mwlaserswe/Frequenzumrichter/Doku Atmel programmieren/20200407_100606 (800 x 600).jpg

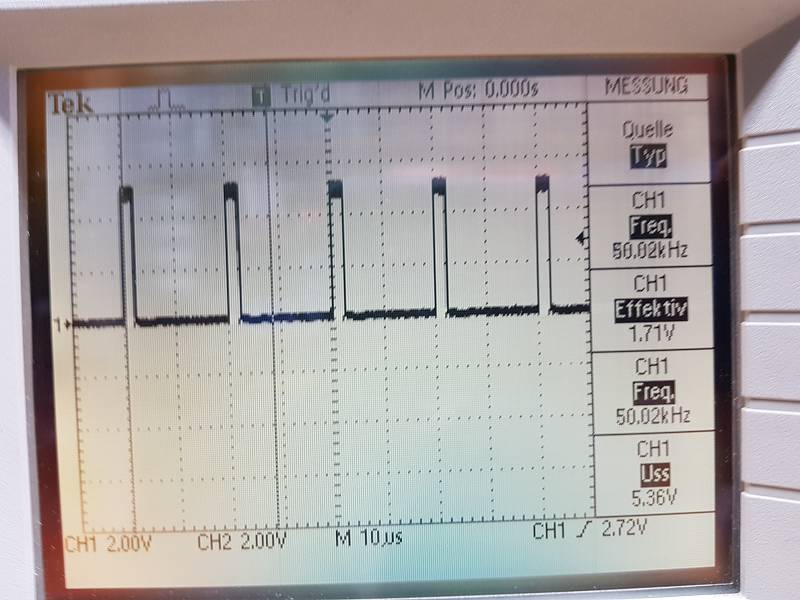
Doku Atmel programmieren/20200407_100606 (800 x 600).jpg
