mwlaserswe/Frequenzumrichter/Arduino/Arduion Uno Layout 2.jpg

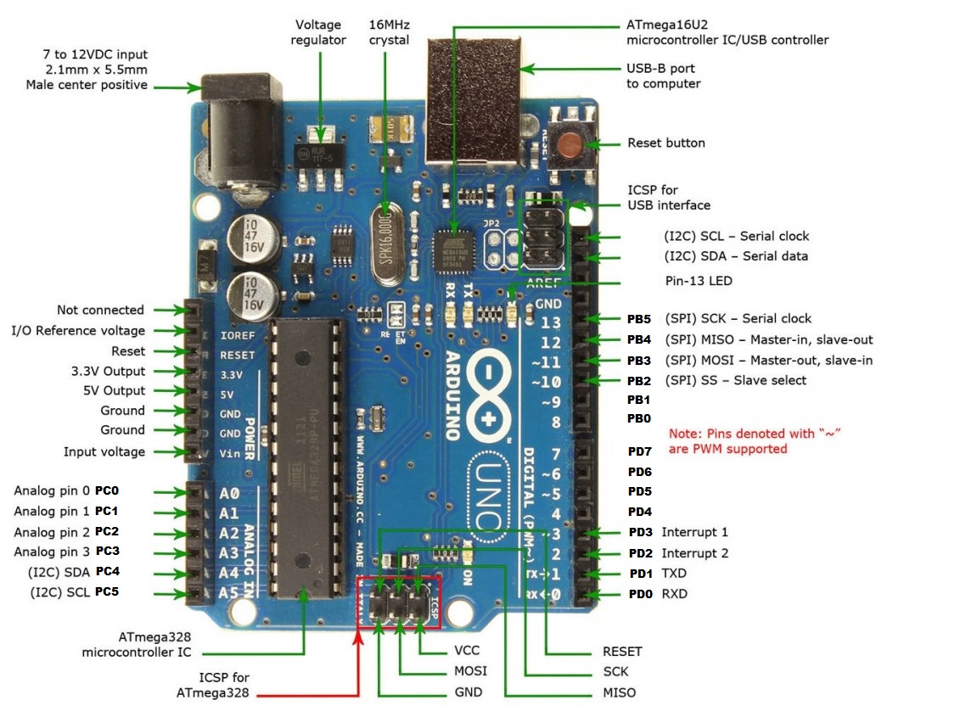
Arduino/Arduion Uno Layout 2.jpg
