mwlaserswe/Frequenzumrichter/Arduino/Arduion Uno Layout.jpg

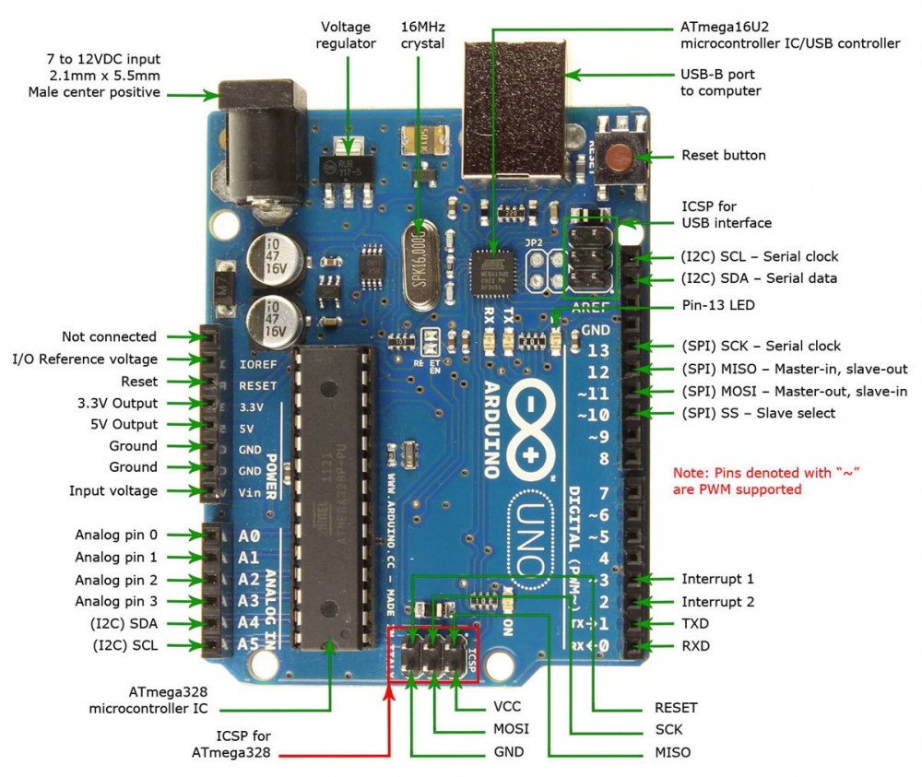
Arduino/Arduion Uno Layout.jpg
