mwlaserswe/Frequenzumrichter/Doku Atmel programmieren/20200329_140703 (800 x 600).jpg

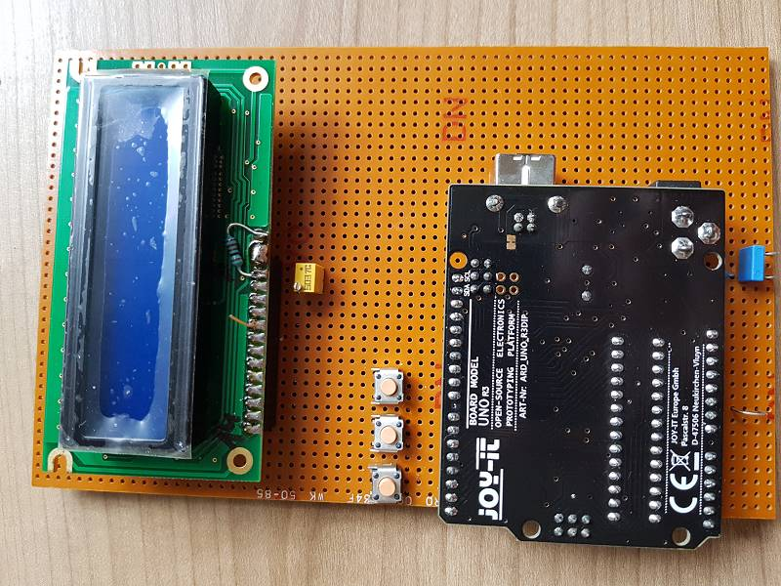
Doku Atmel programmieren/20200329_140703 (800 x 600).jpg
