mwlaserswe/Frequenzumrichter/Doku Atmel programmieren/20200329_143617 (800 x 600).jpg

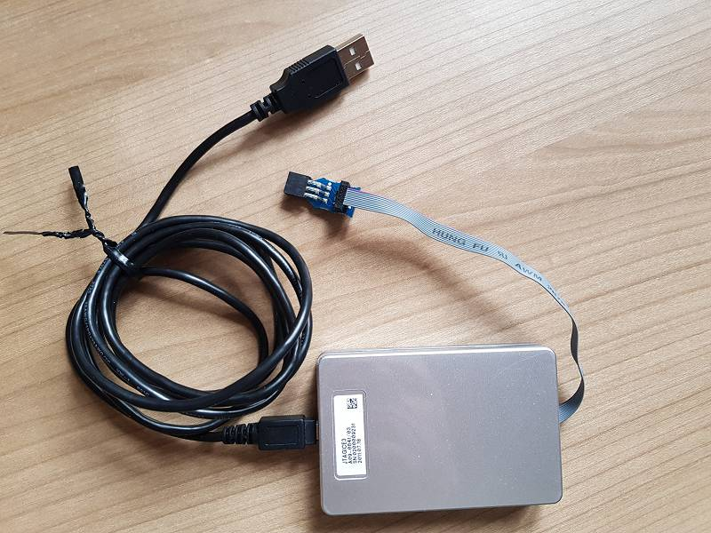
Doku Atmel programmieren/20200329_143617 (800 x 600).jpg
