mwlaserswe/Frequenzumrichter/Doku Atmel programmieren/20200329_144504 (800 x 600).jpg

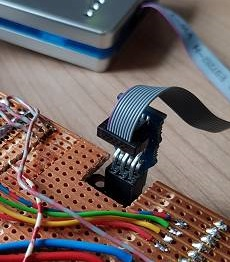
Doku Atmel programmieren/20200329_144504 (800 x 600).jpg
