mwlaserswe/Frequenzumrichter/Doku Atmel programmieren/20200402_160709 (800 x 600).jpg

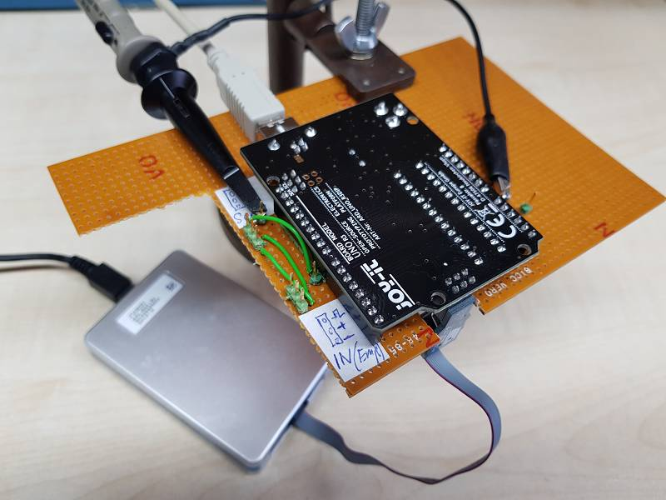
Doku Atmel programmieren/20200402_160709 (800 x 600).jpg
