mwlaserswe/Frequenzumrichter/Doku Atmel programmieren/20200406_111214.jpg

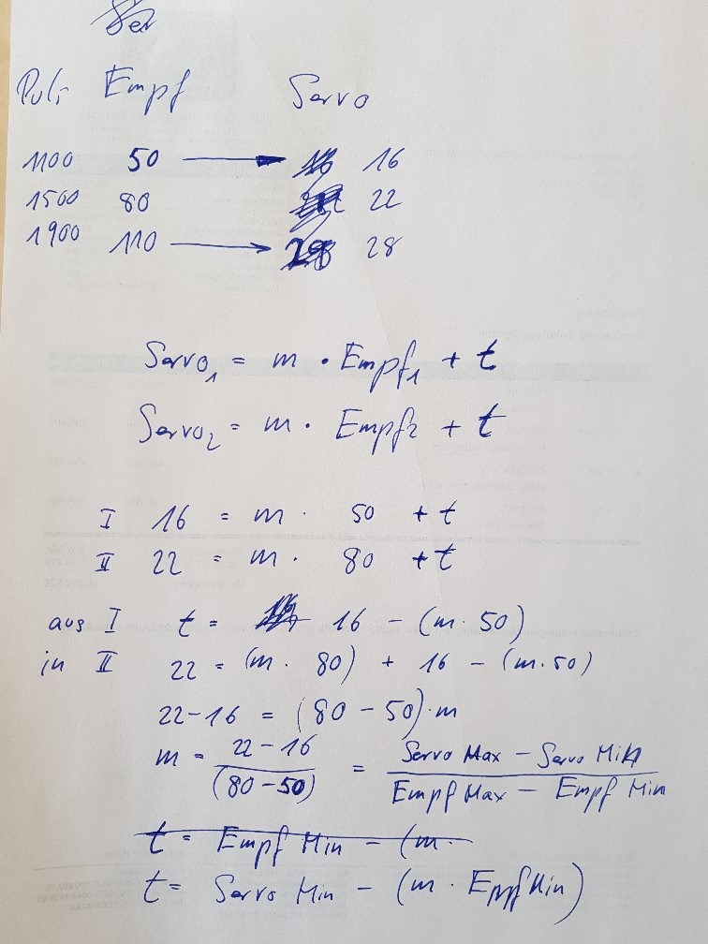
Doku Atmel programmieren/20200406_111214.jpg
