mwlaserswe/Frequenzumrichter/Doku Atmel programmieren/20200406_111307.jpg

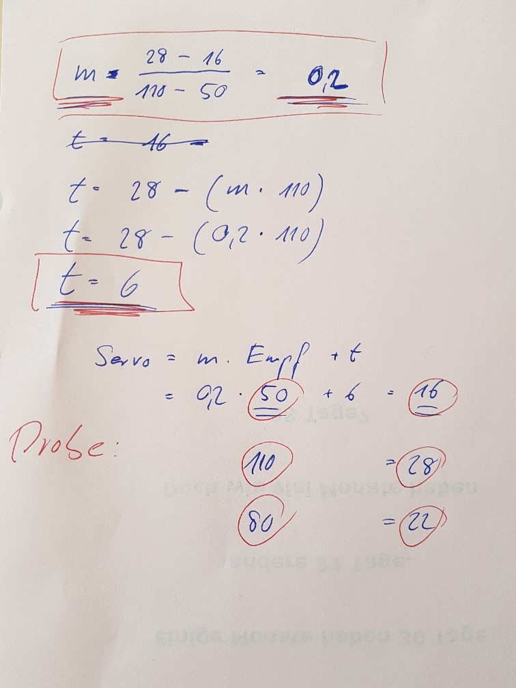
Doku Atmel programmieren/20200406_111307.jpg
