mwlaserswe/Frequenzumrichter/Doku Atmel programmieren/20200407_104357 (800 x 600).jpg

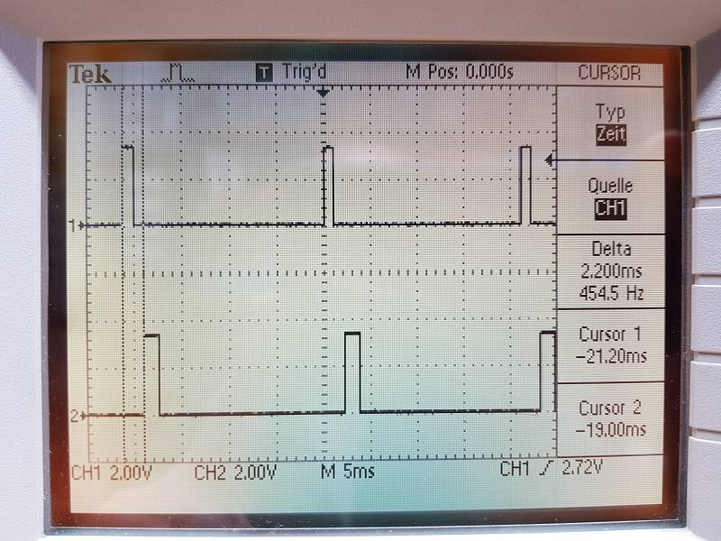
Doku Atmel programmieren/20200407_104357 (800 x 600).jpg
