mwlaserswe/Frequenzumrichter/VF_Sine_Drive/VFD_sinus_AT168/VF_Sine_Drive.png

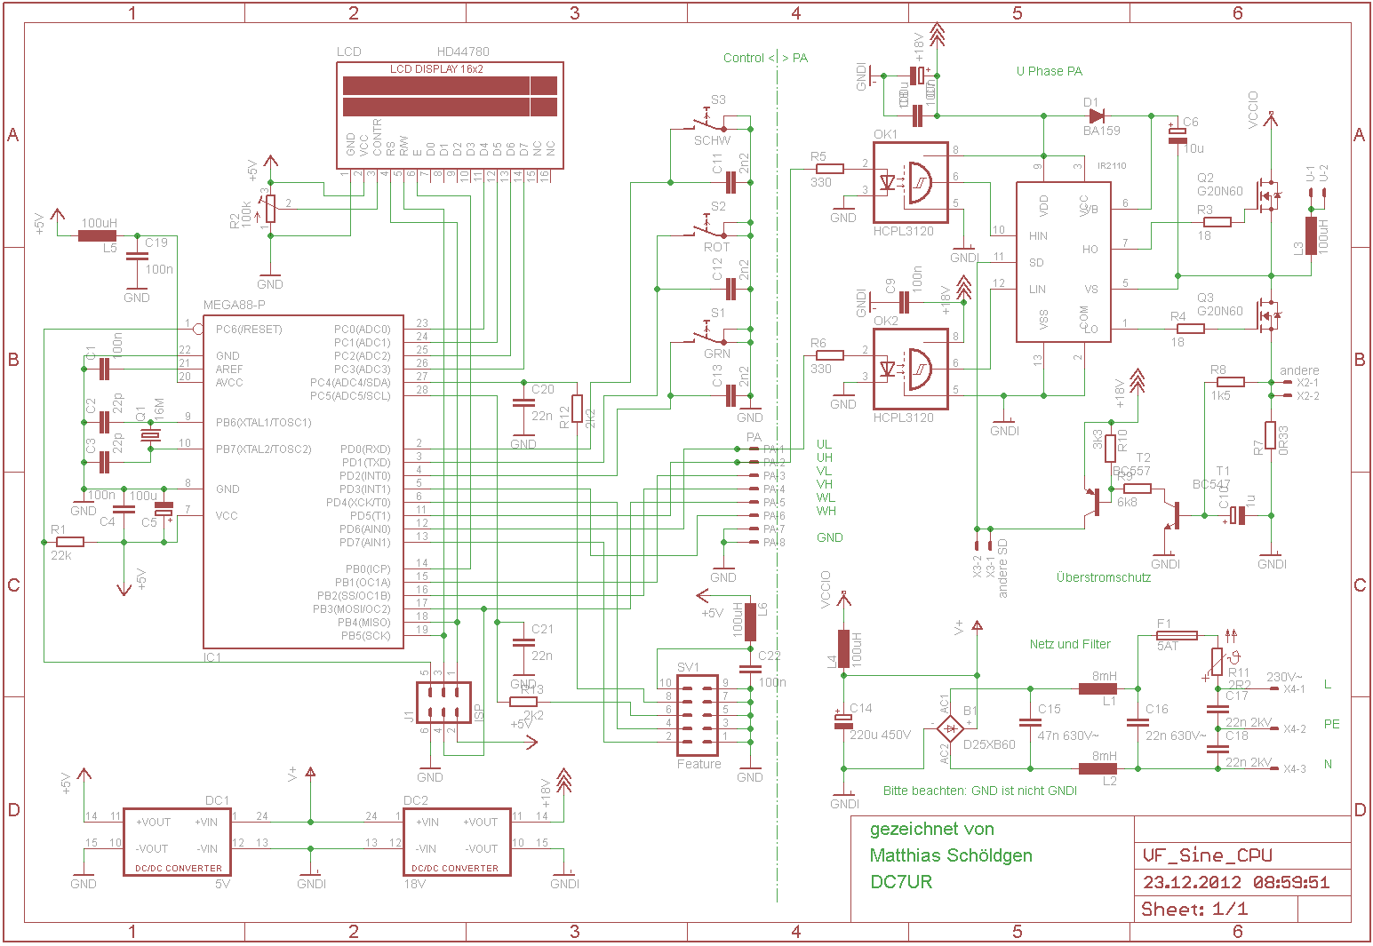
VF_Sine_Drive/VFD_sinus_AT168/VF_Sine_Drive.png
