mwlaserswe/Frequenzumrichter/VF_Sine_Drive/Eagle/VF_Sine_CPU_Mainboard2.brd

## EAGLE design VF_Sine_Drive/Eagle/VF_Sine_CPU_Mainboard2.brd (2018-12-28)

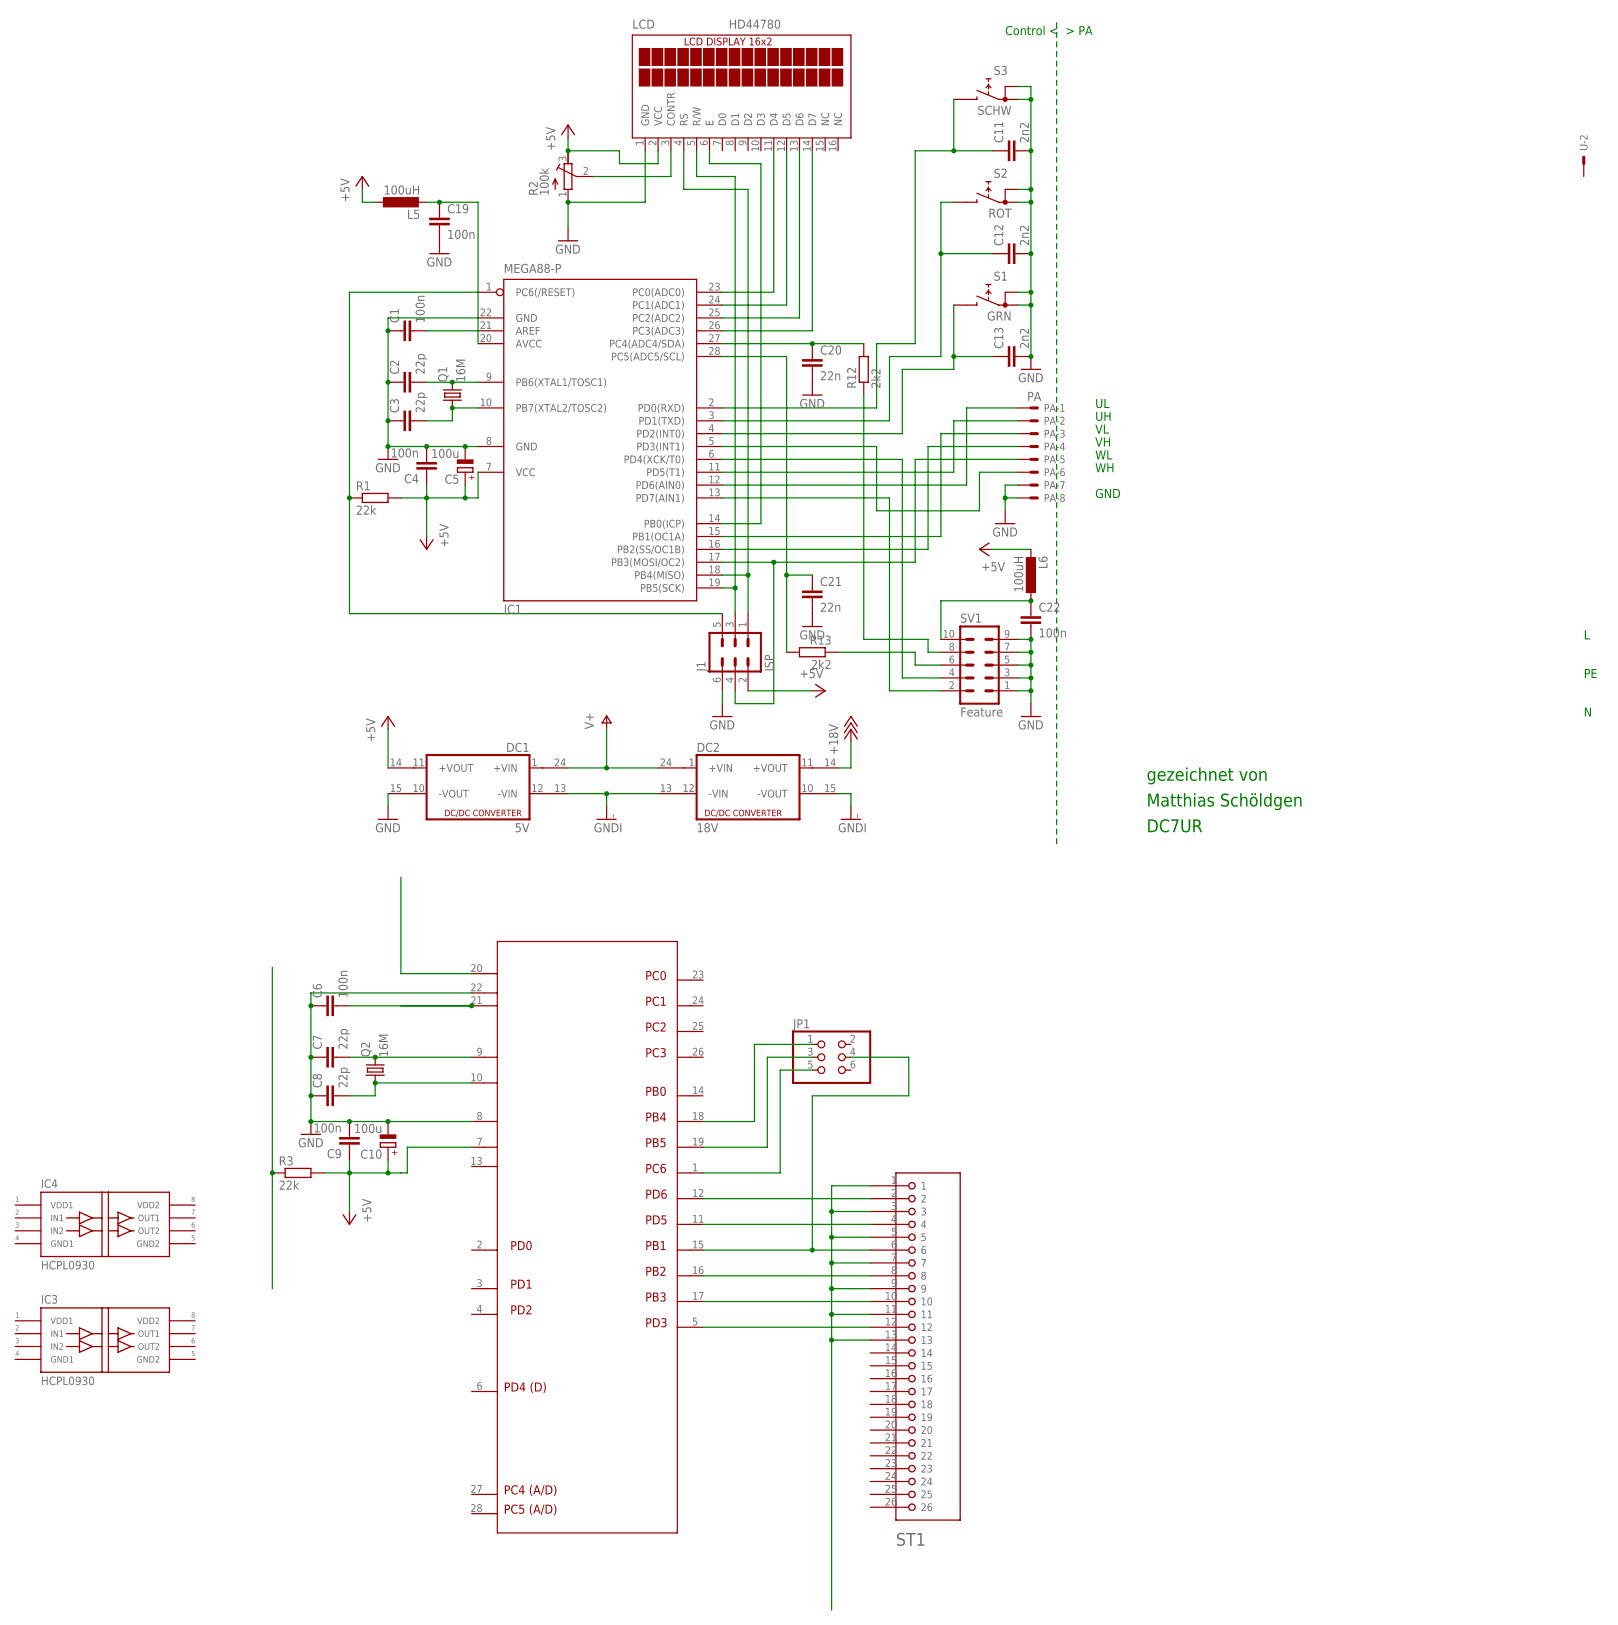
[picture p19: schematic VF_Sine_CPU_Mainboard2.sch]

Parts:
C1, C4, C6, C9, C22: 100n; C025-025X050
C2, C3, C7, C8: 22p; C025-025X050
C5, C10: 100u; B45181A
C11, C12, C13: 2n2; C025-025X050
C19: 100n; C050-030X075
C20, C21: 22n; C025-024X044
DC1: 5V; CMK
DC2: 18V; CMK
IC1: MEGA88-P; DIL28-3
IC2: ATMEGA328P_VAR; DIL-28S
IC3, IC4: HCPL0930; SO8
J1: ISP; ML6
JP1: PINHD-2X3; 2X03
L5, L6: 100uH; 0204/5
LCD: HD44780; TUXGR_16X2_R2
PA: PA; 22-23-2081
Q1, Q2: 16M; HC49/S
R1, R3: 22k; 0207/2V
R2: 100k; RTRIM4G/J
R12, R13: 2k2; 0204/5
S1: GRN; RDT1034
S2: ROT; RDT1034
S3: SCHW; RDT1034
ST1: HD-26
SV1: Feature; ML10
U: 5566-2

Connections:
+5V: C4.1, C5.+, C9.1, C10.+, DC1.14 (+VOUT1), IC1.7 (VCC), IC2.7, J1.2, L5.1, L6.2, LCD.2 (VCC), R1.2, R2.3 (A), R3.2
+18V: DC2.14 (+VOUT1)
GND: C1.1, C2.1, C3.1, C4.2, C5.-, C6.1, C7.1, C8.1, C9.2, C10.-, C11.2, C12.2, C13.2, C19.2, C20.2, C21.2, C22.2, DC1.15 (-VOUT1), IC1.8 (GND), IC1.22 (GND), IC2.8, IC2.22, J1.6, LCD.1 (GND), PA.7, PA.8, R2.1 (E), S1.A, S1.A1, S2.A, S2.A1, S3.A, S3.A1, SV1.1, SV1.3, SV1.5, SV1.7, SV1.9
GNDI: DC1.13 (-VIN1), DC2.13 (-VIN1), DC2.15 (-VOUT1)
unnamed: IC1.18 (PB4(MISO)), J1.1, LCD.4 (RS)
unnamed: IC1.19 (PB5(SCK)), J1.3, LCD.5 (R/W)
unnamed: IC1.17 (PB3(MOSI/OC2)), J1.4, PA.5
unnamed: IC1.1 (PC6(/RESET)), J1.5, R1.1
unnamed: IC1.12 (PD6(AIN0)), PA.1
unnamed: IC1.11 (PD5(T1)), PA.2
unnamed: IC1.15 (PB1(OC1A)), PA.3
unnamed: IC1.16 (PB2(SS/OC1B)), PA.4
unnamed: IC1.5 (PD3(INT1)), PA.6
unnamed: IC1.23 (PC0(ADC0)), LCD.11 (D4)
unnamed: IC1.24 (PC1(ADC1)), LCD.12 (D5)
unnamed: IC1.25 (PC2(ADC2)), LCD.13 (D6)
unnamed: C1.2, IC1.21 (AREF)
unnamed: C2.2, IC1.9 (PB6(XTAL1/TOSC1)), Q1.2
unnamed: C3.2, IC1.10 (PB7(XTAL2/TOSC2)), Q1.1
unnamed: IC1.26 (PC3(ADC3)), LCD.14 (D7)
unnamed: IC1.13 (PD7(AIN1)), SV1.2
unnamed: IC1.14 (PB0(ICP)), LCD.6 (E)
unnamed: LCD.3 (CONTR), R2.2 (S)
unnamed: IC1.6 (PD4(XCK/T0)), SV1.4
unnamed: R12.1, SV1.8
unnamed: R13.1, SV1.6
unnamed: C13.1, IC1.4 (PD2(INT0)), S1.B
unnamed: C12.1, IC1.3 (PD1(TXD)), S2.B
unnamed: C11.1, IC1.2 (PD0(RXD)), S3.B
unnamed: ST1.1, ST1.3, ST1.5, ST1.7, ST1.9, ST1.11, ST1.13
unnamed: IC2.12, ST1.2
unnamed: IC2.11, ST1.4
unnamed: IC2.15, JP1.4, ST1.6
unnamed: IC2.16, ST1.8
unnamed: IC2.17, ST1.10
unnamed: IC2.5, ST1.12
unnamed: IC2.18, JP1.1
unnamed: IC2.19, JP1.3
unnamed: IC2.1, JP1.5
unnamed: C19.1, IC1.20 (AVCC), L5.2
unnamed: C20.1, IC1.27 (PC4(ADC4/SDA)), R12.2
unnamed: C21.1, IC1.28 (PC5(ADC5/SCL)), R13.2
unnamed: C6.2, IC2.21
unnamed: C7.2, IC2.9, Q2.2
unnamed: C8.2, IC2.10, Q2.1
unnamed: C22.1, L6.1, SV1.10
V+: DC1.24 (+VIN1), DC2.24 (+VIN1)

Notes on the sheet:
GND
Matthias Schöldgen
gezeichnet von
DC7UR
Control < > PA
PD5
PD6
PB1
PB2
PB3
PD3
PC1
PC0
PC2
PC3
PB4
PB0
PB5
PC6
PD0
PD1
PD2
PD4 (D)
PC4 (A/D)
PC5 (A/D)

Board: 2 copper layers, 42 parts (0 on the bottom side), 46 nets, no tracks yet.
