mwlaserswe/Frequenzumrichter/VF_Sine_Drive/VFD_sinus_AT168_TST2/GccApplication1/vfdtables.h

 /*  Variable Frequency Drive with AVR ATMega 88/168/328    */
/*! \file *********************************************************************
 *
 *
 *      This file contains the table definitions used for sine control.
 *
 * \par Based on Application note:
 *      AVR447: Sinusoidal driving of three-phase permanent motor using
 *      ATmega48/88/168
 *
 * \par Documentation
 *      For comprehensive code documentation, supported compilers, compiler
 *      settings and supported devices see readme.html
 *
 * \author
 *      Atmel Corporation: http://www.atmel.com \n
 *      Support email: avr@atmel.com
 * 	by Matthias Schoeldgen - DC7UR 
 * $Name: RELEASE_1_0 $
 * $Revision: 1.4 $
 * $RCSfile: PMSMtables.h,v $
 * $Date: 2010/04/16 11:57:20 $  \n
 ******************************************************************************/

#define PURE_SINE_DRIVE 1

#ifndef _PMSM_TABLES_H_
#define _PMSM_TABLES_H_

#ifdef PURE_SINE_DRIVE
const PROGMEM uint8_t sineTable[SINE_TABLE_LENGTH * 3] = {
128,  17,  238,    
132,  15,  236,    
136,  13,  234,    
140,  11,  231,    
144,  10,  229,    
148,  8,   226,    
152,  7,   223,    
156,  5,   221,    
160,  4,   218,    
165,  3,   215,    
168,  2,   212,    
172,  2,   208,    
176,  1,   205,    
180,  1,   202,    
184,  0,   198,    
188,  0,   195,    
191,  0,   191,    
195,  0,   188,    
198,  0,   184,    
202,  1,   180,    
205,  1,   176,    
208,  2,   172,    
212,  2,   168,    
215,  3,   165,    
218,  4,   160,    
221,  5,   156,    
223,  7,   152,    
226,  8,   148,    
229,  10,  144,    
231,  11,  140,    
234,  13,  136,    
236,  15,  132,    
238,  17,  128,    
240,  19,  123,    
242,  21,  119,    
244,  24,  115,    
245,  26,  111,    
247,  29,  107,    
248,  32,  103,    
250,  34,  99,     
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
};    
#else 
/*!   \brief Sine wave modulation table
 *    
 *    Table containing modulation values for all three phases.
 *    The table is organized as [U1,  V1, W1, U2, V2, W2, ...]
 *    for forward driving, and [U1, W1, V1, U2, W2, V2, ...]
 *    for reverse driving.
 */         
const PROGMEM uint8_t sineTable[SINE_TABLE_LENGTH * 3] = {
0,       0,      221,		// Offset 0 
8,       0,      225,
17,      0,      229,
25,      0,      232,
33,      0,      236,
42,      0,      239,
50,      0,      241,
58,      0,      244,
66,      0,      246,
74,      0,      248,
82,      0,      250,
90,      0,      252,
98,      0,      253,
105,     0,      254,
113,     0,      254,
120,     0,      255,		
128,     0,      255,		// 0x10
135,     0,      255,
142,     0,      254,
149,     0,      254,
155,     0,      253,
162,     0,      252,
168,     0,      250,
174,     0,      248,
180,     0,      246,
186,     0,      244,
192,     0,      241,
197,     0,      239,
202,     0,      236,
207,     0,      232,
212,     0,      229,
217,     0,      225,
221,     0,      221,		// 0x20
225,     0,      217,
229,     0,      212,
232,     0,      207,
236,     0,      202,
239,     0,      197,
241,     0,      192,
244,     0,      186,
246,     0,      180,
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
};
#endif
// provide compatibility with GCC definitions
// sometimes needed, sometimes not. Lets disable them here until we want them
/*
#define PB0 0
#define PB1 1
#define PB2 2
#define PB3 3
#define PB4 4
#define PB5 5
#define PB6 6
#define PB7 7

#define PC0 0
#define PC1 1
#define PC2 2

#define PD0 0
#define PD1 1
#define PD2 2
#define PD3 3
#define PD4 4
#define PD5 5
#define PD6 6
#define PD7 7
*/
// PHASES to pins

#define VH PB1
#define VL PB2
#define WH PB3

#define WL PD3
#define UL PD5
#define UH PD6




#endif
