mwlaserswe/Frequenzumrichter/TestPrg_Arduino_UNO/SWE_11_Arduino_02/GccApplication1/main.c

// PWM an Port PD6
// Hardware Arduino UNO


#include <avr/io.h>

volatile uint32_t cnt;
#define DisplayDelay 50000

int main (void)
{
	// 8-Bit PWM
	// Für PD6 ist Timer 0 zuständig
	// es gibt zwei TC0 Control Register: TCCR0A und TCCR0B
	//    WGM01,WGM00 = 1,1    heißt Fast PWM
	//    COM0A1,COM0A0 = 1,0  heißt Clear OC0A on compare match, set OC0A at BOTTOM (Non-inverting mode)
	//    CS01,CS00 = 1,1      heißt clk/1 (no prescaling)
	TCCR0A = ((1 << COM0A1) | (1 << WGM01) | (1 << WGM00) );
	TCCR0B = ((1 << CS10) | (1 << CS00));
	
	// Port PD6 auf Output setzen
	DDRD |= (1 << PIND6);
	
		
	while(1)
	{
		// duty cycle setzen
		OCR0A = 70;
		for (cnt=0; cnt<=DisplayDelay; cnt++) {;}
			
		// duty cycle setzen
		OCR0A = 200;
		for (cnt=0; cnt<=DisplayDelay; cnt++) {;}
	}

	

}
