mwlaserswe/Frequenzumrichter/(commit log)

2018-10-23 SWE: first commit
    [VF_Sine_CPU.sch]
2018-10-26 Test: Lauflicht mit den grünen LED's auf dem EVK1100
2018-10-26 Test: Taste drücken, dann geht die entsprechende grüne LED an
2018-12-09 SWE: Viele, viele Änderungen
    [VF_Sine_CPU.sch]
2018-12-17 SWE: neue Arduino-Projekte
2018-12-28 SWE: D-Sub Testadapter
    [D-Sub Adapter.brd, D-Sub Adapter.sch]
2018-12-28 SWE: Cleanup
    [VF_Sine_CPU.sch]
2018-12-28 SWE: Mainboard from Stephan
    [VF_Sine_CPU_Mainboard.brd, VF_Sine_CPU_Mainboard.sch, VF_Sine_CPU_Mainboard2.brd, VF_Sine_CPU_Mainboard2.sch]
2018-12-30 SWE: Arduino UNO Layout mit den Ports beschriftet
2020-04-01 SWE: Neues Arduino Projekt: Servo Ansteuerung
2020-04-05 SWE: Servo 1 working
2020-04-07 SWE: Servo working. Ready for layout.
2020-04-12 SWE: Move "Servo" project to separate path
    [D-Sub Adapter.brd, D-Sub Adapter.sch]
