mwlaserswe/Frequenzumrichter/Doku Atmel programmieren/20200329_174218.jpg

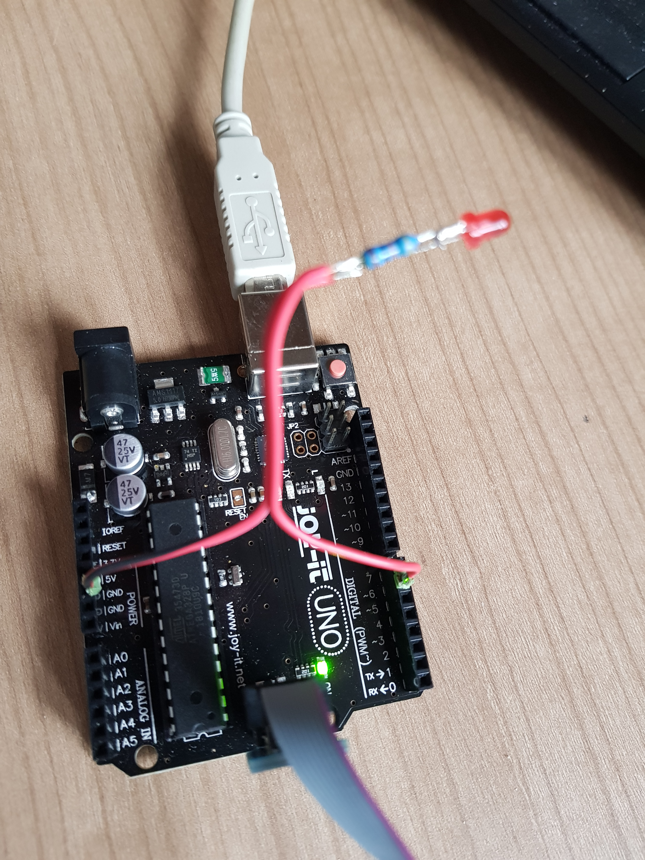
Doku Atmel programmieren/20200329_174218.jpg
